ImogenWren/mini-truss-pcb/Documentation/Finished Product Photos/Truss Experiment Container.png

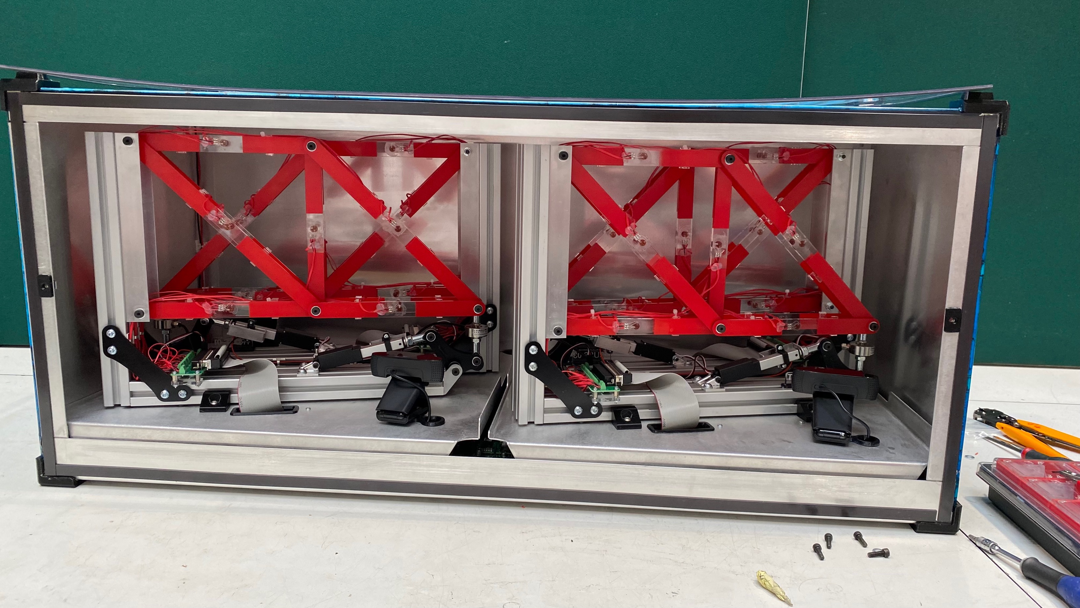
Documentation/Finished Product Photos/Truss Experiment Container.png
