ImogenWren/mini-truss-pcb/Documentation/Board Layout V1.0.png

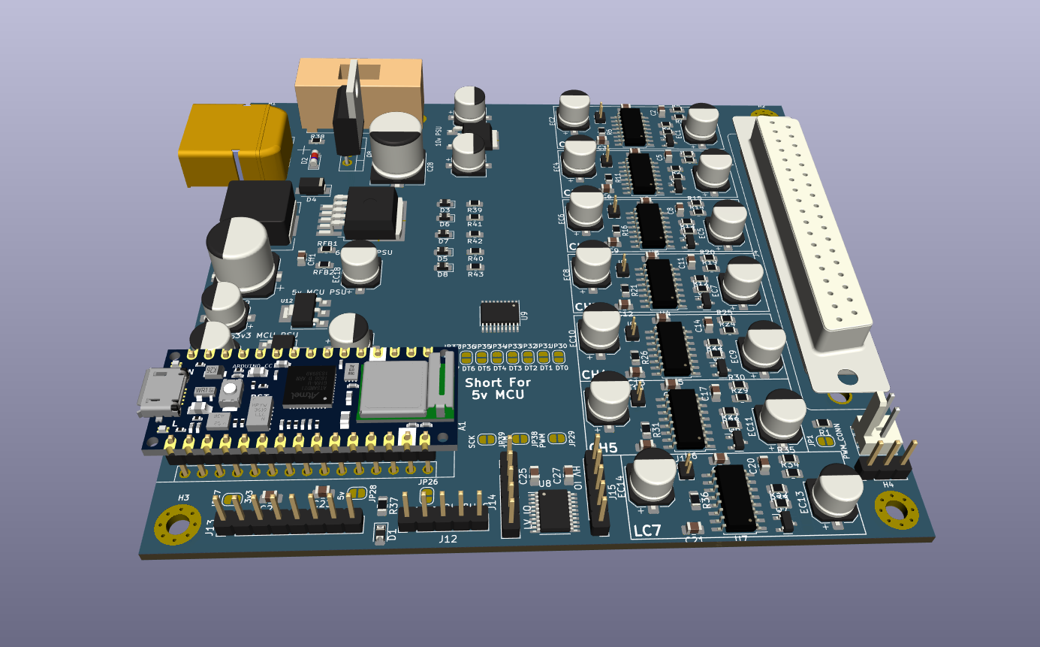
Documentation/Board Layout V1.0.png
