ImogenWren/mini-truss-pcb/README.md

# truss_PCB
