ImogenWren/mini-truss-pcb/Documentation/Buck converter schematic.png

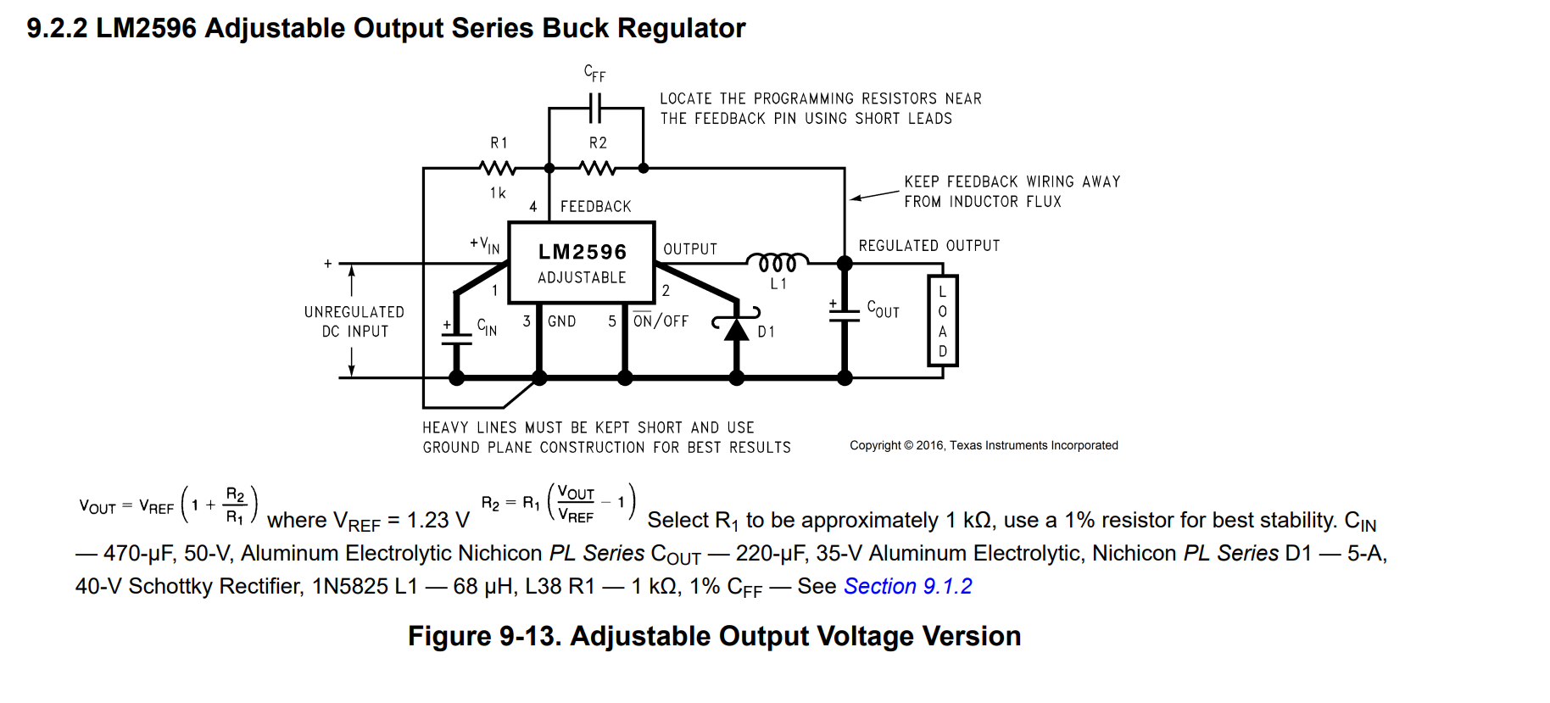
Documentation/Buck converter schematic.png
