ImogenWren/mini-truss-pcb/Documentation/Finished Product Photos/Truss Containers 2.png

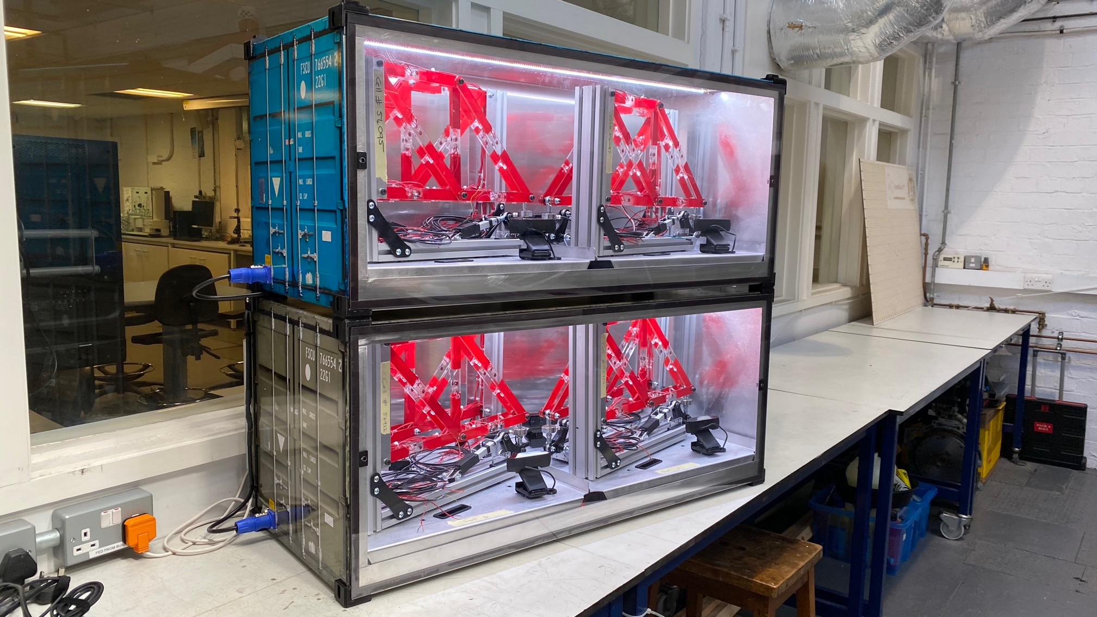
Documentation/Finished Product Photos/Truss Containers 2.png
