ImogenWren/mini-truss-pcb/Documentation/Finished Product Photos/Truss Containers.png

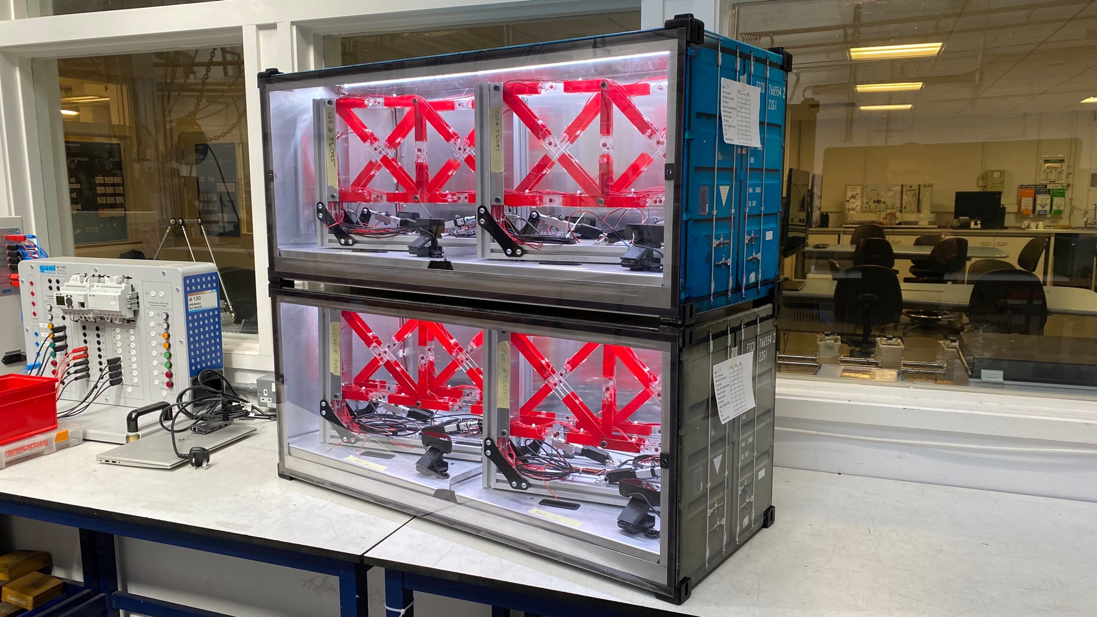
Documentation/Finished Product Photos/Truss Containers.png
