ImogenWren/mini-truss-pcb/Documentation/Finished Product Photos/Truss Expreiment Tray.png

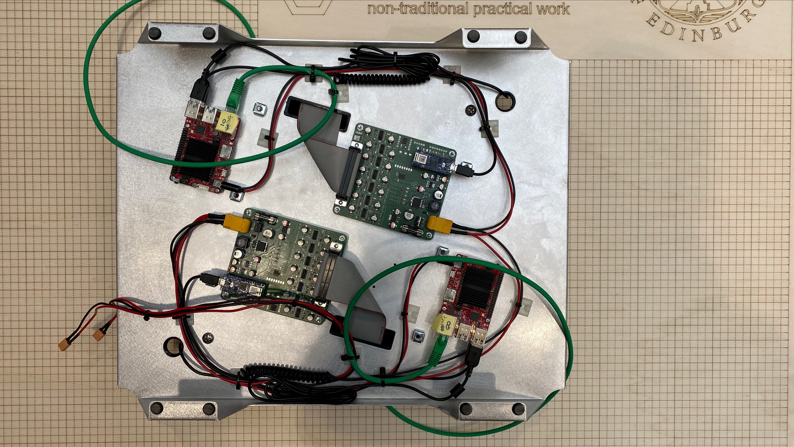
Documentation/Finished Product Photos/Truss Expreiment Tray.png
