ImogenWren/mini-truss-pcb/Documentation/HX711 Application Circuit.png

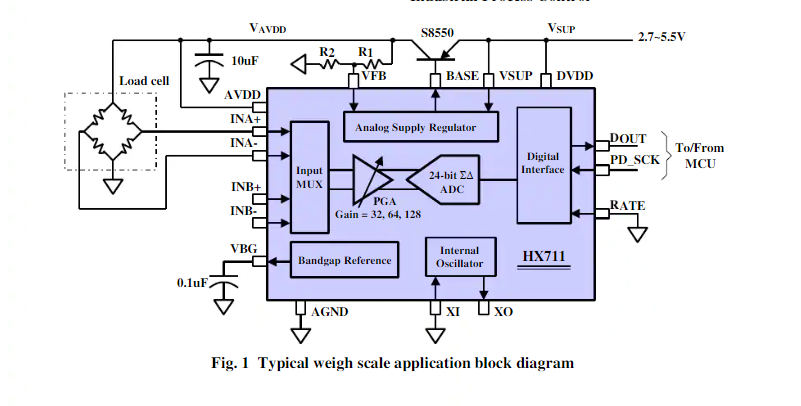
Documentation/HX711 Application Circuit.png
