ImogenWren/mini-truss-pcb/Documentation/HX711 pinout.png

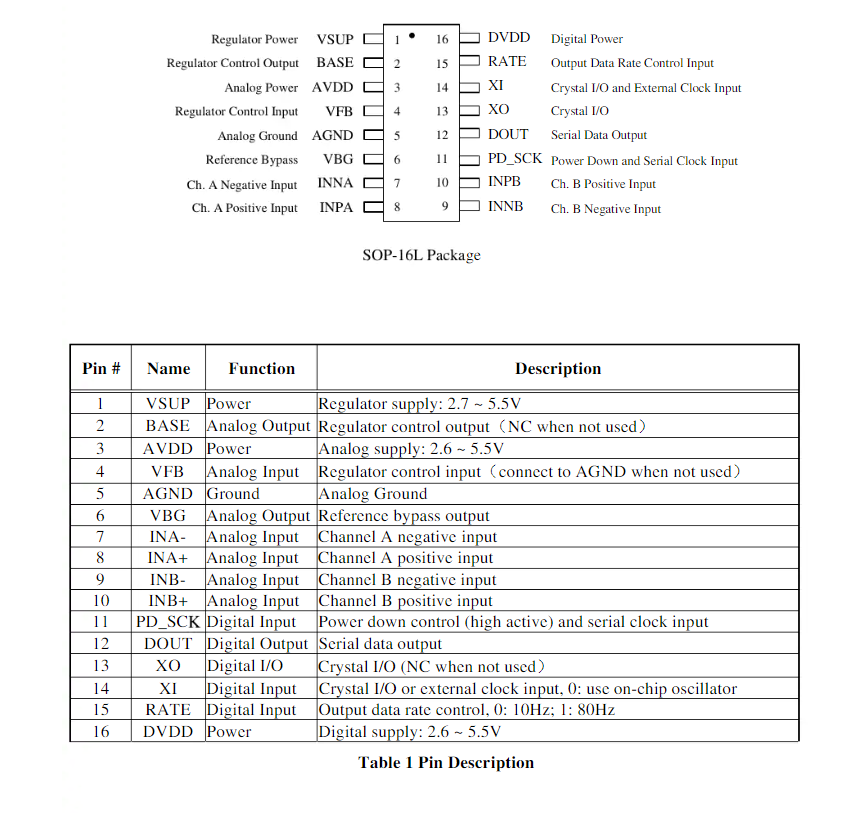
Documentation/HX711 pinout.png
