ImogenWren/mini-truss-pcb/Documentation/Truss Diagram.jpg

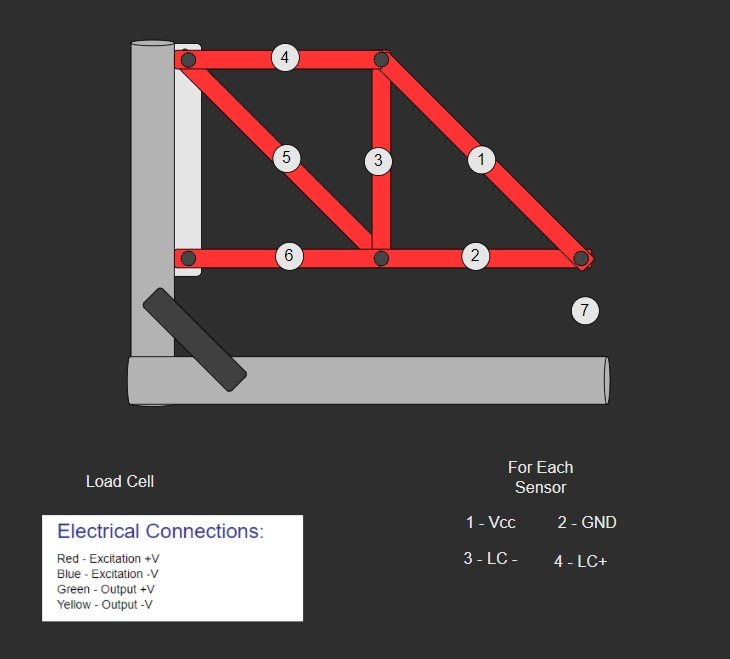
Documentation/Truss Diagram.jpg
