ImogenWren/mini-truss-pcb/Documentation/Truss PCB Adaptor.png

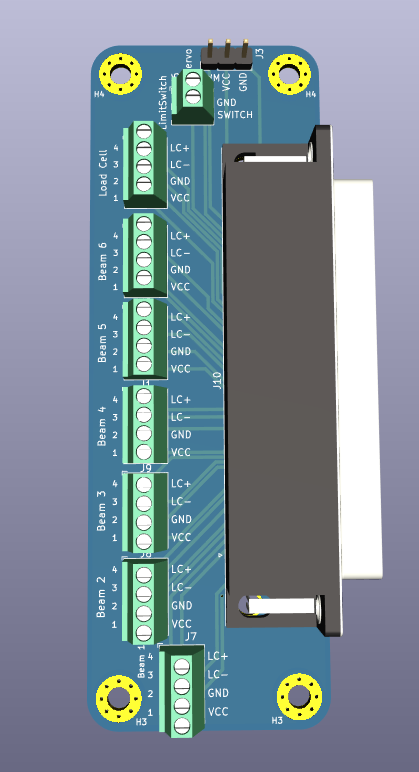
Documentation/Truss PCB Adaptor.png
