ImogenWren/mini-truss-pcb/Documentation/Truss Adaptor PCB Layout.pdf

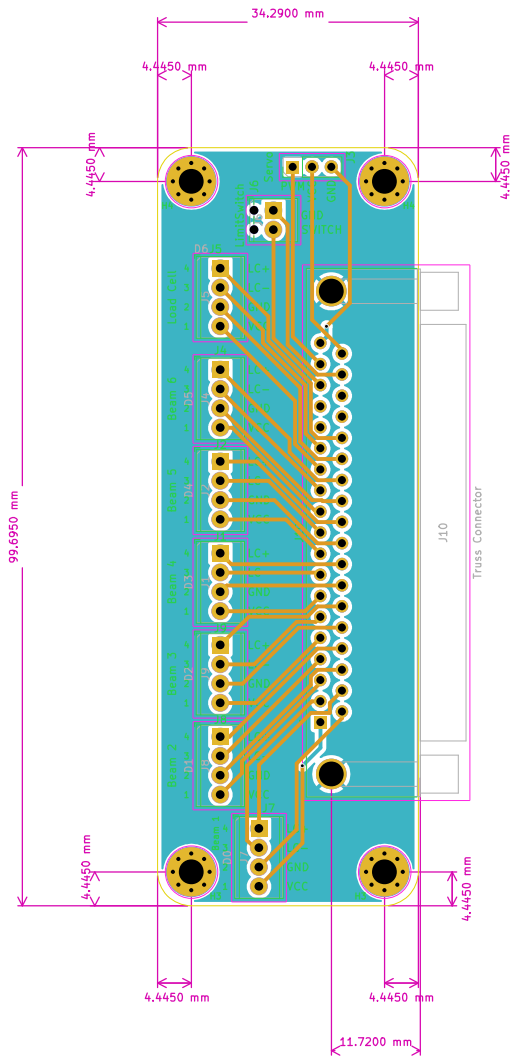
[picture p11: page 1]
