ImogenWren/mini-truss-pcb/Documentation/Truss_PCB_mounting hole template.pdf

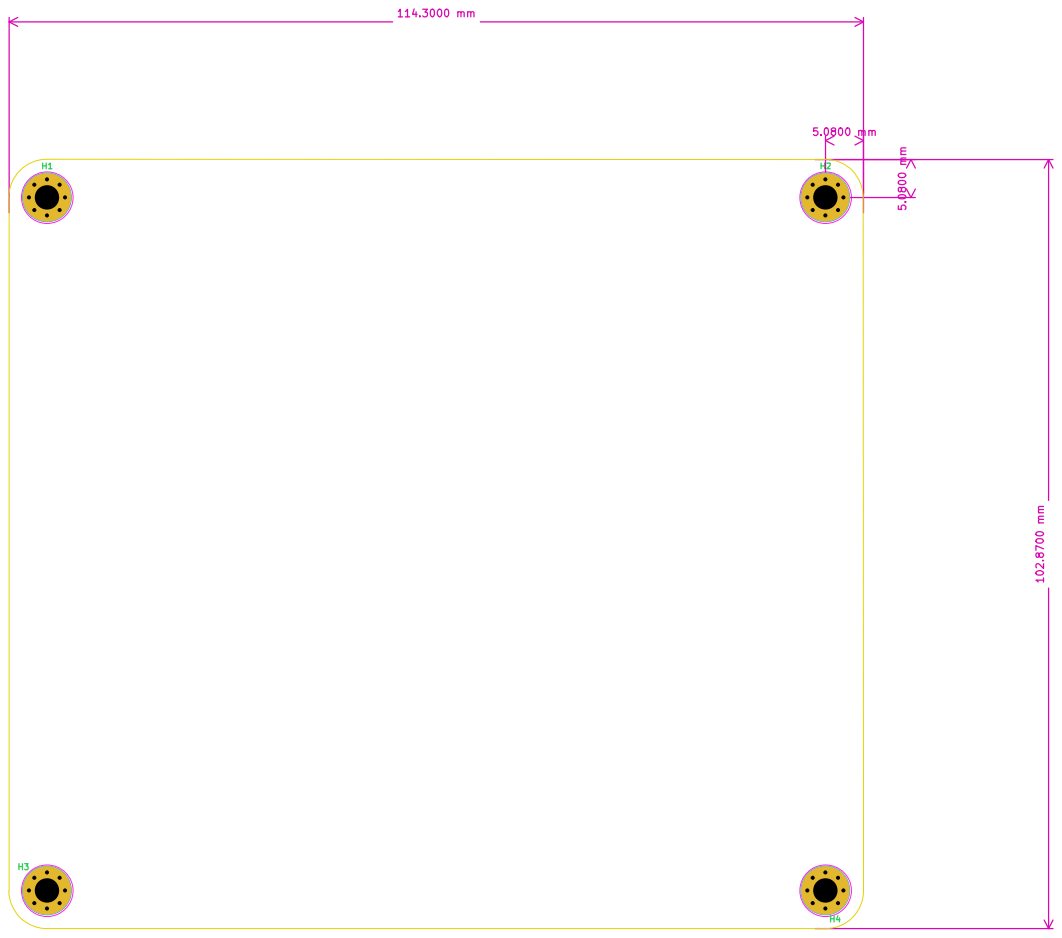
[picture p12: page 1]
