ImogenWren/mini-truss-pcb/truss_PCB/truss_PCB.kicad_pcb

## KiCad design truss_PCB/truss_PCB.kicad_pcb (2022-09-29)

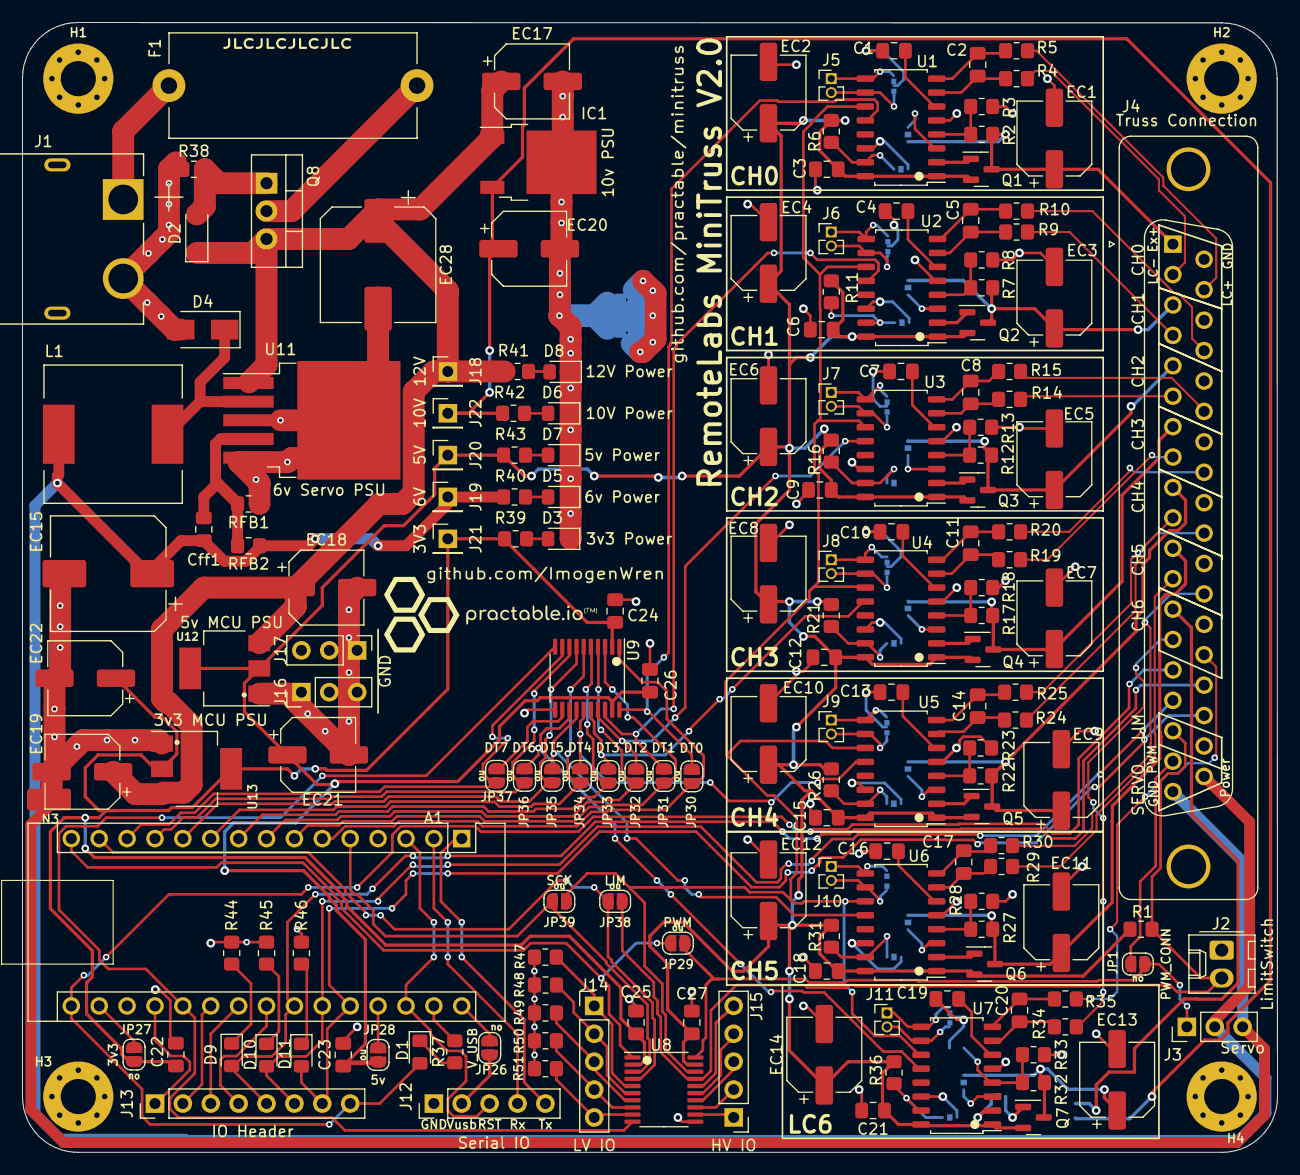
[picture p13: board truss_PCB.kicad_pcb from above]

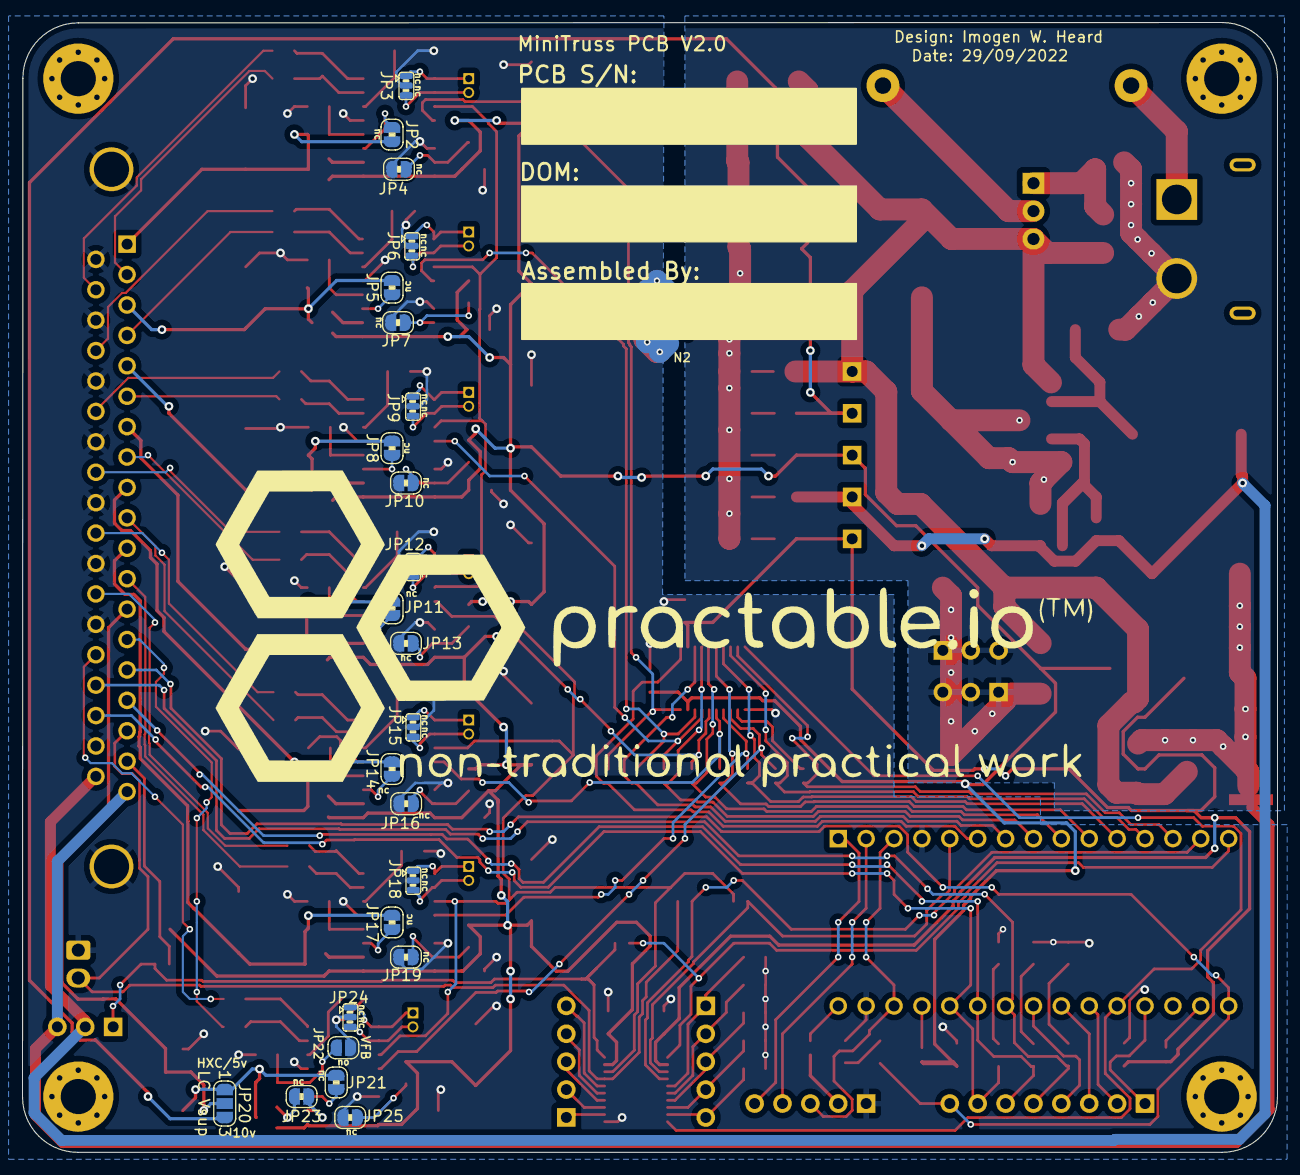
[picture p14: board truss_PCB.kicad_pcb from below]

Board: 2 copper layers, 114.3 x 102.9 mm, 205 parts (25 on the bottom side), 157 nets.

Parts:
A1: Arduino_Nano_v3.x; Arduino_Nano
C1, C2, C3, C4, C5, C6, C7, C8, C9, C10, C11, C12, C13, C14, C15, C16, C17, C18, C19, C20, C21, C22, C23, C24, C25, C26, C27: 100n; C_0805_2012Metric_Pad1.18x1.45mm_HandSolder
Cff1: 3n3; C_0805_2012Metric_Pad1.18x1.45mm_HandSolder
D1, D9, D10, D11: LED; D_0805_2012Metric_Pad1.15x1.40mm_HandSolder
D2: BZV55B9V1; D_MiniMELF
D3: 3v3 Power; D_0805_2012Metric_Pad1.15x1.40mm_HandSolder
D4: 1N5821; D_SMA
D5: 6v Power; D_0805_2012Metric_Pad1.15x1.40mm_HandSolder
D6: 10V Power; D_0805_2012Metric_Pad1.15x1.40mm_HandSolder
D7: 5v Power; D_0805_2012Metric_Pad1.15x1.40mm_HandSolder
D8: 12V Power; D_0805_2012Metric_Pad1.15x1.40mm_HandSolder
EC1, EC2, EC3, EC4, EC5, EC6, EC7, EC8, EC9, EC10, EC11, EC12, EC13, EC14, EC20, EC21, EC22: 10u; CP_Elec_6.3x5.9
EC15: 100u; CP_Elec_10x10
EC17, EC18, EC19: 22u; CP_Elec_6.3x5.9
EC28: 680u; CP_Elec_10x10
F1: 3A; Fuseholder_Cylinder-5x20mm_Stelvio-Kontek_PTF78_Horizontal_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
H1, H2, H3, H4: MountingHole_M3; MountingHole_3.2mm_M3_Pad_Via
IC1: BAJ0BC0FP-E2; TO-252-2
J1: XT60_60A_male; AMASS_XT60PW-M
J2: LimitSwitch; Molex_KK-254_AE-6410-02A_1x02_P2.54mm_Vertical
J3: Servo; PinHeader_1x03_P2.54mm_Vertical
J4: Truss Connection; DSUB-37_Female_Vertical_P2.77x2.84mm_MountingHoles
J5, J6, J7, J8, J9, J10, J11: IN_B; PinHeader_1x02_P1.27mm_Vertical
J12: Serial IO; PinHeader_1x05_P2.54mm_Vertical
J13: IO Header; PinHeader_1x08_P2.54mm_Vertical
J14: LV IO; PinHeader_1x05_P2.54mm_Vertical
J15: HV IO; PinHeader_1x05_P2.54mm_Vertical
J16, J17: GND; PinHeader_1x03_P2.54mm_Vertical
J18: 12V; PinHeader_1x01_P2.54mm_Vertical
J19: 6V; PinHeader_1x01_P2.54mm_Vertical
J20: 5V; PinHeader_1x01_P2.54mm_Vertical
J21: 3V3; PinHeader_1x01_P2.54mm_Vertical
J22: 10V; PinHeader_1x01_P2.54mm_Vertical
JP1: PWM_CONN; SolderJumper-2_P1.3mm_Open_RoundedPad1.0x1.5mm
JP2, JP5, JP8, JP11, JP14, JP17, JP21: Gain; SolderJumper-2_P1.3mm_Bridged_RoundedPad1.0x1.5mm
JP3, JP6, JP9, JP12, JP15, JP18, JP24: INB GND; SolderJumper-3_P1.3mm_Bridged12_RoundedPad1.0x1.5mm_DoubleJ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
JP4, JP7, JP10, JP13, JP16, JP19: Sample Rate; SolderJumper-2_P1.3mm_Bridged_RoundedPad1.0x1.5mm
JP20: LC Vsup; SolderJumper-3_P1.3mm_Open_RoundedPad1.0x1.5mm_NumberLabels
JP22: VFB; SolderJumper-2_P1.3mm_Open_RoundedPad1.0x1.5mm
JP23: Base; SolderJumper-2_P1.3mm_Bridged_RoundedPad1.0x1.5mm
JP25: SampleRate; SolderJumper-2_P1.3mm_Bridged_RoundedPad1.0x1.5mm
JP26: V_USB; SolderJumper-2_P1.3mm_Open_RoundedPad1.0x1.5mm
JP27: 3v3; SolderJumper-2_P1.3mm_Open_RoundedPad1.0x1.5mm
JP28: 5v; SolderJumper-2_P1.3mm_Open_RoundedPad1.0x1.5mm
JP29: PWM; SolderJumper-2_P1.3mm_Open_RoundedPad1.0x1.5mm
JP30: DT0; SolderJumper-2_P1.3mm_Open_RoundedPad1.0x1.5mm
JP31: DT1; SolderJumper-2_P1.3mm_Open_RoundedPad1.0x1.5mm
JP32: DT2; SolderJumper-2_P1.3mm_Open_RoundedPad1.0x1.5mm
JP33: DT3; SolderJumper-2_P1.3mm_Open_RoundedPad1.0x1.5mm
JP34: DT4; SolderJumper-2_P1.3mm_Open_RoundedPad1.0x1.5mm
JP35: DT5; SolderJumper-2_P1.3mm_Open_RoundedPad1.0x1.5mm
JP36: DT6; SolderJumper-2_P1.3mm_Open_RoundedPad1.0x1.5mm
JP37: DT7; SolderJumper-2_P1.3mm_Open_RoundedPad1.0x1.5mm
JP38: LIM; SolderJumper-2_P1.3mm_Open_RoundedPad1.0x1.5mm
JP39: SCK; SolderJumper-2_P1.3mm_Open_RoundedPad1.0x1.5mm
L1: 33uH; L_12x12mm_H8mm
N2, N3: pwr_tie; NetTie-8-15A_1oz_2oz
Q1, Q2, Q3, Q4, Q5, Q6, Q7: BC807; SOT-23
Q8: IRF5305_PBF; TO-220-3_Vertical
R1, R6, R11, R16, R21, R26, R31, R36, R40, R47, R48, R49, R50, R51: 10k; R_0805_2012Metric_Pad1.20x1.40mm_HandSolder
R2, R7, R12, R17, R22, R27, R32: 12k; R_0805_2012Metric_Pad1.20x1.40mm_HandSolder
R3, R8, R13, R18, R23, R28, R33: 33k; R_0805_2012Metric_Pad1.20x1.40mm_HandSolder
R4, R5, R9, R10, R14, R15, R19, R20, R24, R25, R29, R30, R34, R35: 100r; R_0805_2012Metric_Pad1.20x1.40mm_HandSolder
R37, R43, R44, R45, R46: 1k; R_0805_2012Metric_Pad1.20x1.40mm_HandSolder
R38, R39: 330r; R_0805_2012Metric_Pad1.20x1.40mm_HandSolder
R41, R42: 8k2; R_0805_2012Metric_Pad1.20x1.40mm_HandSolder
RFB1: 860r; R_0805_2012Metric_Pad1.20x1.40mm_HandSolder
RFB2: 3k3; R_0805_2012Metric_Pad1.20x1.40mm_HandSolder
U1, U2, U3, U4, U5, U6, U7: HX711; SOP-16_4.55x10.3mm_P1.27mm
U8, U9: TXS0108EPW; TSSOP-20_4.4x6.5mm_P0.65mm
U11: LM2596S-ADJ; TO-263-5_TabPin3
U12: AMS1117-5.0; SOT-223-3_TabPin2
U13: AMS1117-3.3; SOT-223-3_TabPin2

Connections:
3V3DC: C22.1, C24.1, C25.1, EC22.1, J21.1, JP27.2 (B), R39.2, U8.2 (VCCA), U9.2 (VCCA), U13.2 (VO)
5VDC: C3.1, C6.1, C9.1, C12.1, C15.1, C18.1, C21.1, C23.1, C26.1, C27.1, EC2.1, EC4.1, EC6.1, EC8.1, EC10.1, EC12.1, EC14.1, EC21.1, J20.1, JP28.2 (B), Q1.2 (E), Q2.2 (E), Q3.2 (E), Q4.2 (E), Q5.2 (E), Q6.2 (E), Q7.2 (E), R1.2, R6.1, R11.1, R16.1, R21.1, R26.1, R31.1, R36.1, R43.2, U1.1 (Vdd), U1.16 (DVdd), U2.1 (Vdd), U2.16 (DVdd), U3.1 (Vdd), U3.16 (DVdd), U4.1 (Vdd), U4.16 (DVdd), U5.1 (Vdd), U5.16 (DVdd), U6.1 (Vdd), U6.16 (DVdd), U7.1 (Vdd), U7.16 (DVdd), U8.19 (VCCB), U9.19 (VCCB), U12.2 (VO)
/10V_DC: EC20.1, IC1.3 (OUT), J22.1, JP20.3 (B), R42.2
/BridgeDriver0/D_OUT: JP30.1 (A), U1.12 (Dout), U9.20 (B1)
/BridgeDriver0/LC+: J4.21, R5.2
/BridgeDriver0/LC-: J4.2, R4.2
/BridgeDriver0/V_LC: EC1.1, J4.1, JP2.2 (B), Q1.3 (C), R2.2
/BridgeDriver1/D_OUT: JP31.1 (A), U2.12 (Dout), U9.18 (B2)
/BridgeDriver1/LC+: J4.23, R10.2
/BridgeDriver1/LC-: J4.4, R9.2
/BridgeDriver1/V_LC: EC3.1, J4.3, JP5.2 (B), Q2.3 (C), R7.2
/BridgeDriver2/D_OUT: JP32.1 (A), U3.12 (Dout), U9.17 (B3)
/BridgeDriver2/LC+: J4.25, R15.2
/BridgeDriver2/LC-: J4.6, R14.2
/BridgeDriver2/V_LC: EC5.1, J4.5, JP8.2 (B), Q3.3 (C), R12.2
/BridgeDriver3/D_OUT: JP33.1 (A), U4.12 (Dout), U9.16 (B4)
/BridgeDriver3/LC+: J4.27, R20.2
/BridgeDriver3/LC-: J4.8, R19.2
/BridgeDriver3/V_LC: EC7.1, J4.7, JP11.2 (B), Q4.3 (C), R17.2
/BridgeDriver4/D_OUT: JP34.1 (A), U5.12 (Dout), U9.15 (B5)
/BridgeDriver4/LC+: J4.29, R25.2
/BridgeDriver4/LC-: J4.10, R24.2
/BridgeDriver4/V_LC: EC9.1, J4.9, JP14.2 (B), Q5.3 (C), R22.2
/BridgeDriver5/D_OUT: JP35.1 (A), U6.12 (Dout), U9.14 (B6)
/BridgeDriver5/LC+: J4.31, R30.2
/BridgeDriver5/LC-: J4.12, R29.2
/BridgeDriver5/V_LC: EC11.1, J4.11, JP17.2 (B), Q6.3 (C), R27.2
/LIMIT_SWITCH: J2.2, J4.17, JP38.1 (A), R1.1, U8.17 (B3)
/LoadCell/D_OUT: JP36.1 (A), U7.12 (Dout), U9.13 (B7)
/LoadCell/LC+: J4.33, R35.2
/LoadCell/LC-: J4.14, R34.2
/LoadCell/V_LC: J4.13, JP20.2 (C)
/MCU/DATA_7: JP37.1 (A), U9.12 (B8)
/MCU/DT0: A1.6 (D3), JP30.2 (B), U9.1 (A1)
/MCU/DT1: A1.7 (D4), JP31.2 (B), U9.3 (A2)
/MCU/DT2: A1.8 (D5), JP32.2 (B), U9.4 (A3)
/MCU/DT3: A1.9 (D6), JP33.2 (B), U9.5 (A4)
/MCU/DT4: A1.10 (D7), JP34.2 (B), U9.6 (A5)
/MCU/DT5: A1.11 (D8), JP35.2 (B), U9.7 (A6)
/MCU/DT6: A1.12 (D9), JP36.2 (B), U9.8 (A7)
/MCU/DT7: A1.13 (D10), JP37.2 (B), U9.9 (A8)
/MCU/LED_2: A1.24 (A5), D9.2 (A), J4.34, J13.5
/MCU/LED_3: A1.25 (A6), D10.2 (A), J4.16, J13.6
/MCU/LED_4: A1.26 (A7), D11.2 (A), J4.35, J13.7
/MCU/LIMIT_SWITCH: A1.14 (D11), JP38.2 (B), U8.4 (A3)
/MCU/OUTPUT_ENABLE: A1.20 (A1), U8.10 (OE), U9.10 (OE)
/MCU/RST: A1.3 (~RESET), A1.28 (~RESET), J12.3
/MCU/RX: A1.2 (D0/RX), J12.4
/MCU/SCK: A1.5 (D2), JP39.2 (B), U8.3 (A2)
/MCU/SERVO_PWM_PIN: A1.15 (D12), JP29.2 (B), U8.1 (A1)
/MCU/SPARE_0: A1.16 (D13), D1.2 (A), J4.15, J13.8
/MCU/TX: A1.1 (D1/TX), J12.5
/MCU/V_USB: J12.2, JP26.2 (B)
/PWM: J4.18, JP1.1 (A)
/Power Distribution/6VDC: D4.1 (K), L1.1, U11.2 (OUT)
/Power Distribution/12V: F1.2, Q8.2 (D)
/Power Distribution/12V_00: D2.2 (A), Q8.1 (G), R38.2
/Power Distribution/12V_BUS: D2.1 (K), EC17.1, EC18.1, EC19.1, EC28.1, IC1.1 (VCC), J18.1, Q8.3 (S), R41.2, U11.1 (VIN), U12.3 (VI), U13.3 (VI)
/Power Distribution/12V_IN: F1.1, J1.2 (V+)
/Power Distribution/FB: Cff1.1, RFB1.1, RFB2.2, U11.4 (FB)
/SERVO_GND: J3.3, J4.19, N3.2 (C)
/SERVO_POWER: Cff1.2, EC15.1, J3.2, J4.37, J19.1, L1.2, R40.2, RFB2.1
/SERVO_PWM: J3.1, JP1.2 (B), JP29.1 (A), U8.20 (B1)
GNDA: A1.4 (GND), A1.29 (GND), C1.2, C3.2, C4.2, C6.2, C7.2, C9.2, C10.2, C12.2, C13.2, C15.2, C16.2, C18.2, C19.2, C21.2, C22.2, C23.2, C24.2, C25.2, C26.2, C27.2, EC1.2, EC2.2, EC3.2, EC4.2, EC5.2, EC6.2, EC7.2, EC8.2, EC9.2, EC10.2, EC11.2, EC12.2, EC13.2, EC14.2, J2.1, J4.0 (PAD), J4.20, J4.22, J4.24, J4.26, J4.28, J4.30, J4.32, J4.36, J12.1, JP3.2 (C), JP4.1 (A), JP6.2 (C), JP7.1 (A), JP9.2 (C), JP10.1 (A), JP12.2 (C), JP13.1 (A), JP15.2 (C), JP16.1 (A), JP18.2 (C), JP19.1 (A), JP22.2 (B), JP24.2 (C), JP25.1 (A), N2.1 (A), R3.1, R8.1, R13.1, R18.1, R23.1, R28.1, R33.1, R37.1, R44.1, R45.1, R46.1, R47.1, R48.1, R49.1, R50.1, R51.1, U1.5 (AGND), U1.14 (XI), U2.5 (AGND), U2.14 (XI), U3.5 (AGND), U3.14 (XI), U4.5 (AGND), U4.14 (XI), U5.5 (AGND), U5.14 (XI), U6.5 (AGND), U6.14 (XI), U7.5 (AGND), U7.14 (XI), U8.11 (GND), U9.11 (GND)
GNDPWR: D3.1 (K), D4.2 (A), D5.1 (K), D6.1 (K), D7.1 (K), D8.1 (K), EC15.2, EC17.2, EC18.2, EC19.2, EC20.2, EC21.2, EC22.2, EC28.2, IC1.2 (GND), J1.1 (V-), J16.1, J16.2, J16.3, J17.1, J17.2, J17.3, N2.2 (C), N3.1 (A), R38.1, RFB1.2, U11.3 (GND), U11.5 (~ON/OFF), U12.1 (GND), U13.1 (GND)
unnamed: A1.17 (3V3), JP27.1 (A)
unnamed: A1.19 (A0), J13.1
unnamed: A1.21 (A2), J13.2
unnamed: A1.22 (A3), J13.3
unnamed: A1.23 (A4), J13.4
unnamed: A1.27 (+5V), JP28.1 (A)
unnamed: A1.30 (VIN), JP26.1 (A)
unnamed: C1.1, U1.6 (VBG)
unnamed: C2.1, R4.1, U1.7 (INA-)
unnamed: C2.2, R5.1, U1.8 (INA+)
unnamed: C4.1, U2.6 (VBG)
unnamed: C5.1, R9.1, U2.7 (INA-)
unnamed: C5.2, R10.1, U2.8 (INA+)
unnamed: C7.1, U3.6 (VBG)
unnamed: C8.1, R14.1, U3.7 (INA-)
unnamed: C8.2, R15.1, U3.8 (INA+)
unnamed: C10.1, U4.6 (VBG)
unnamed: C11.1, R19.1, U4.7 (INA-)
unnamed: C11.2, R20.1, U4.8 (INA+)
unnamed: C13.1, U5.6 (VBG)
unnamed: C14.1, R24.1, U5.7 (INA-)
unnamed: C14.2, R25.1, U5.8 (INA+)
unnamed: C16.1, U6.6 (VBG)
unnamed: C17.1, R29.1, U6.7 (INA-)
unnamed: C17.2, R30.1, U6.8 (INA+)
unnamed: C19.1, U7.6 (VBG)
unnamed: C20.1, R34.1, U7.7 (INA-)
unnamed: C20.2, R35.1, U7.8 (INA+)
unnamed: D1.1 (K), R37.2
unnamed: D3.2 (A), R39.1
unnamed: D5.2 (A), R40.1
unnamed: D6.2 (A), R42.1
unnamed: D7.2 (A), R43.1
unnamed: D8.2 (A), R41.1
unnamed: D9.1 (K), R44.2
unnamed: D10.1 (K), R45.2
unnamed: D11.1 (K), R46.2
unnamed: EC13.1, JP20.1 (A), JP21.2 (B), Q7.3 (C), R32.2
unnamed: J5.1, JP3.1 (A), U1.9 (INB-)
unnamed: J5.2, JP3.3 (B), U1.10 (INB+)
unnamed: J6.1, JP6.1 (A), U2.9 (INB-)
unnamed: J6.2, JP6.3 (B), U2.10 (INB+)
unnamed: J7.1, JP9.1 (A), U3.9 (INB-)
unnamed: J7.2, JP9.3 (B), U3.10 (INB+)
unnamed: J8.1, JP12.1 (A), U4.9 (INB-)
unnamed: J8.2, JP12.3 (B), U4.10 (INB+)
unnamed: J9.1, JP15.1 (A), U5.9 (INB-)
unnamed: J9.2, JP15.3 (B), U5.10 (INB+)
unnamed: J10.1, JP18.1 (A), U6.9 (INB-)
unnamed: J10.2, JP18.3 (B), U6.10 (INB+)
unnamed: J11.1, JP24.1 (A), U7.9 (INB-)
unnamed: J11.2, JP24.3 (B), U7.10 (INB+)
unnamed: J14.1, R47.2, U8.5 (A4)
unnamed: J14.2, R48.2, U8.6 (A5)
unnamed: J14.3, R49.2, U8.7 (A6)
unnamed: J14.4, R50.2, U8.8 (A7)
unnamed: J14.5, R51.2, U8.9 (A8)
unnamed: J15.1, U8.12 (B8)
unnamed: J15.2, U8.13 (B7)
unnamed: J15.3, U8.14 (B6)
unnamed: J15.4, U8.15 (B5)
unnamed: J15.5, U8.16 (B4)
unnamed: JP2.1 (A), U1.3 (AVdd)
unnamed: JP4.2 (B), R6.2, U1.15 (Rate)
unnamed: JP5.1 (A), U2.3 (AVdd)
unnamed: JP7.2 (B), R11.2, U2.15 (Rate)
unnamed: JP8.1 (A), U3.3 (AVdd)
unnamed: JP10.2 (B), R16.2, U3.15 (Rate)
unnamed: JP11.1 (A), U4.3 (AVdd)
unnamed: JP13.2 (B), R21.2, U4.15 (Rate)
unnamed: JP14.1 (A), U5.3 (AVdd)
unnamed: JP16.2 (B), R26.2, U5.15 (Rate)
unnamed: JP17.1 (A), U6.3 (AVdd)
unnamed: JP19.2 (B), R31.2, U6.15 (Rate)
unnamed: JP21.1 (A), U7.3 (AVdd)
unnamed: JP22.1 (A), R32.1, R33.2, U7.4 (VFB)
unnamed: JP23.1 (A), U7.2 (Base)
unnamed: JP23.2 (B), Q7.1 (B)
unnamed: JP25.2 (B), R36.2, U7.15 (Rate)
unnamed: Q1.1 (B), U1.2 (Base)
unnamed: Q2.1 (B), U2.2 (Base)
unnamed: Q3.1 (B), U3.2 (Base)
unnamed: Q4.1 (B), U4.2 (Base)
unnamed: Q5.1 (B), U5.2 (Base)
unnamed: Q6.1 (B), U6.2 (Base)
unnamed: R2.1, R3.2, U1.4 (VFB)
unnamed: R7.1, R8.2, U2.4 (VFB)
unnamed: R12.1, R13.2, U3.4 (VFB)
unnamed: R17.1, R18.2, U4.4 (VFB)
unnamed: R22.1, R23.2, U5.4 (VFB)
unnamed: R27.1, R28.2, U6.4 (VFB)
SCK: JP39.1 (A), U1.11 (PD_SCK), U2.11 (PD_SCK), U3.11 (PD_SCK), U4.11 (PD_SCK), U5.11 (PD_SCK), U6.11 (PD_SCK), U7.11 (PD_SCK), U8.18 (B2)
