ImogenWren/mini-truss-pcb/truss_connector_breakout/truss_connector_breakout.kicad_pcb

## KiCad design truss_connector_breakout/truss_connector_breakout.kicad_pcb (2022-09-07)

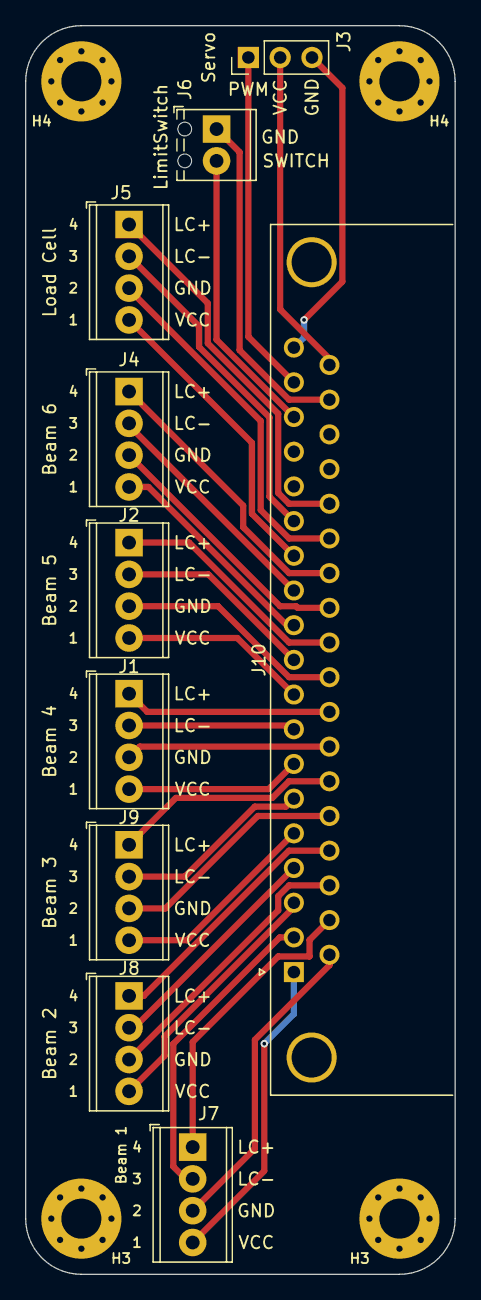
[picture p15: board truss_connector_breakout.kicad_pcb from above]

Board: 2 copper layers, 34.3 x 99.7 mm, 14 parts (0 on the bottom side), 33 nets.

Parts:
H3, H3#2, H4, H4#2: MountingHole_M3; MountingHole_3.2mm_M3_Pad_Via
J1: D3; TerminalBlock_Phoenix_MPT-0,5-4-2.54_1x04_P2.54mm_Horizontal
J2: D4; TerminalBlock_Phoenix_MPT-0,5-4-2.54_1x04_P2.54mm_Horizontal
J3: Servo; PinHeader_1x03_P2.54mm_Vertical
J4: D5; TerminalBlock_Phoenix_MPT-0,5-4-2.54_1x04_P2.54mm_Horizontal
J5: D6; TerminalBlock_Phoenix_MPT-0,5-4-2.54_1x04_P2.54mm_Horizontal
J6: LimitSwitch; TerminalBlock_Phoenix_MPT-0,5-2-2.54_1x02_P2.54mm_Horizontal
J7: D0; TerminalBlock_Phoenix_MPT-0,5-4-2.54_1x04_P2.54mm_Horizontal
J8: D1; TerminalBlock_Phoenix_MPT-0,5-4-2.54_1x04_P2.54mm_Horizontal
J9: D2; TerminalBlock_Phoenix_MPT-0,5-4-2.54_1x04_P2.54mm_Horizontal
J10: Truss Connector; DSUB-37_Male_Horizontal_P2.77x2.84mm_EdgePinOffset9.90mm_Ho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

Connections:
/D0_GND: J7.3, J10.20
/D0_LC+: J7.1, J10.21
/D0_LC-: J7.2, J10.2
/D0_VCC: J7.4, J10.1
/D1_GND: J8.3, J10.22
/D1_LC+: J8.1, J10.23
/D1_LC-: J8.2, J10.4
/D1_VCC: J8.4, J10.3
/D2_GND: J9.3, J10.24
/D2_LC+: J9.1, J10.25
/D2_LC-: J9.2, J10.6
/D2_VCC: J9.4, J10.5
/D3_GND: J1.3, J10.26
/D3_LC+: J1.1, J10.27
/D3_LC-: J1.2, J10.8
/D3_VCC: J1.4, J10.7
/D4_GND: J2.3, J10.28
/D4_LC+: J2.1, J10.29
/D4_LC-: J2.2, J10.10
/D4_VCC: J2.4, J10.9
/D5_GND: J4.3, J10.30
/D5_LC+: J4.1, J10.31
/D5_LC-: J4.2, J10.12
/D5_VCC: J4.4, J10.11
/D6_GND: J5.3, J10.32
/D6_LC+: J5.1, J10.33
/D6_LC-: J5.2, J10.14
/D6_VCC: J5.4, J10.13
/LIMIT_SWITCH: J6.2, J10.17
/LS_GND: J6.1, J10.36
/PWM_SERVO: J3.1, J10.18
/SERVO_GND: J3.3, J10.19
/SERVO_VCC: J3.2, J10.37
