ImogenWren/mini-truss-pcb/(commit log)

2022-07-04 daily update
    [Voltage Divider Calc.xlsx, bridge_driver0_sch.kicad_sch, load_cell.kicad_sch, micro_controller_sch.kicad_sch, power_distribution_sch.kicad_sch, truss_PCB.kicad_pcb, truss_PCB.kicad_sch]
2022-07-07 Added lots of files
    [load_cell.kicad_sch, truss_PCB.csv, truss_PCB.kicad_pcb, truss_PCB.kicad_sch]
2022-08-12 Rearranged folders
    [actuator_sch.kicad_sch, bridge_driver0_sch.kicad_sch, load_cell.kicad_sch, micro_controller_sch.kicad_sch, power_distribution_sch.kicad_sch, truss_PCB.csv, truss_PCB.kicad_pcb, truss_PCB.kicad_sch]
2022-08-15 adding connector board
    [actuator_sch.kicad_sch, bridge_driver0_sch.kicad_sch, load_cell.kicad_sch, micro_controller_sch.kicad_sch, power_distribution_sch.kicad_sch, truss_connector_breakout.kicad_pcb, truss_connector_breakout.kicad_sch]
2022-08-18 added modified for PCB firmware
2022-09-07 updating truss PCB
    [bridge_driver0_sch.kicad_sch, micro_controller_sch.kicad_sch, power_distribution_sch.kicad_sch, truss_PCB.kicad_pcb, truss_PCB.kicad_sch, truss_connector_breakout.kicad_pcb]
2022-09-27 Board V2 Almost Finished TODO# RUN DRC
    [power_distribution_sch.kicad_sch, truss_PCB.kicad_pcb, truss_PCB.kicad_sch]
2022-09-28 Finished PCB Version 2 Design
    [bridge_driver0_sch.kicad_sch, micro_controller_sch.kicad_sch, power_distribution_sch.kicad_sch, truss_PCB.kicad_pcb, truss_PCB.kicad_sch]
2022-09-29 Version 2 pcb complete
    [BOM_Truss_PCB.xlsx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]
